chaBotsMX/Robotnik-2024/modelos/Soccer Field 2021 draft v2.png

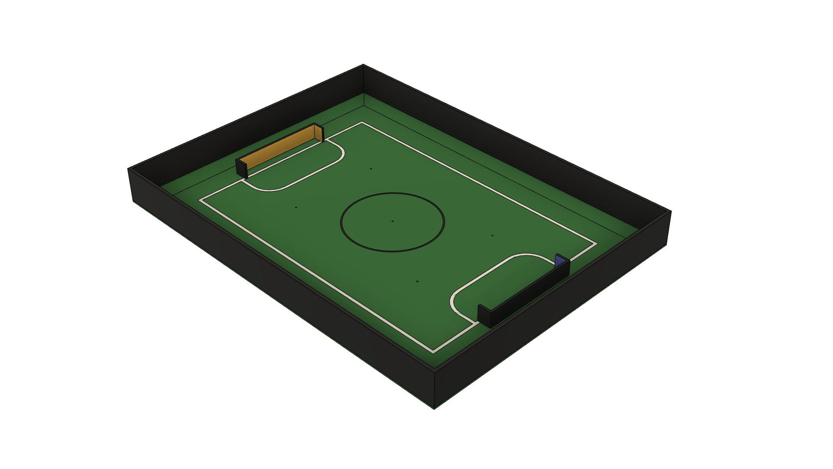
modelos/Soccer Field 2021 draft v2.png
