chaBotsMX/Robotnik-2024/modelos/Soccer Field 2021 draft v2.step

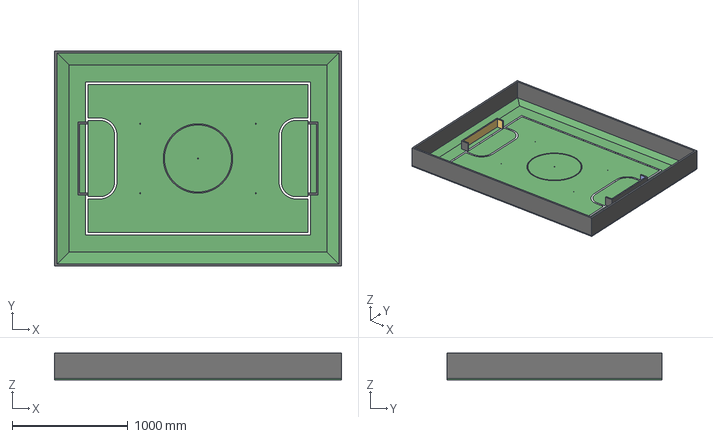
[picture p2: CAD file, 2024-01-22]
modelos/Soccer Field 2021 draft v2.step
2480.0 x 1860.0 x 230.0 mm
