chaBotsMX/Robotnik-2024/pcbs/02_Cople v9.stl

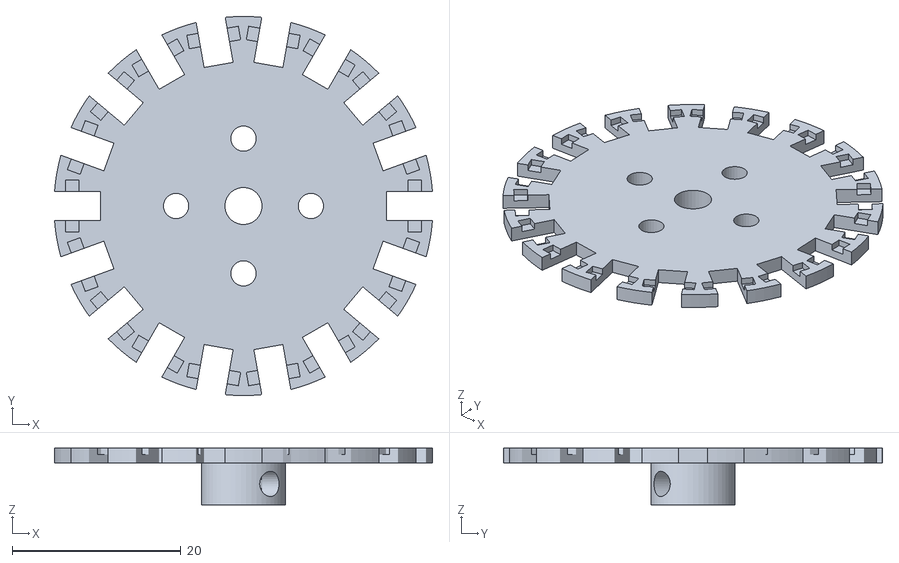
[picture p3: CAD file, 2024-01-18]
pcbs/02_Cople v9.stl
44.9 x 45.0 x 6.75
