chaBotsMX/Robotnik-2024/pcbs/06_Tapita v10.stl

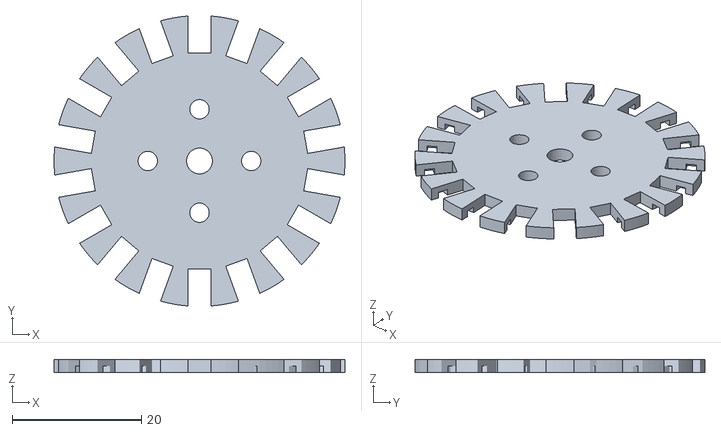
[picture p4: CAD file, 2024-01-18]
pcbs/06_Tapita v10.stl
45.0 x 44.9 x 2.00
