chaBotsMX/Robotnik-2024/pcbs/22_Mirror v8.stl

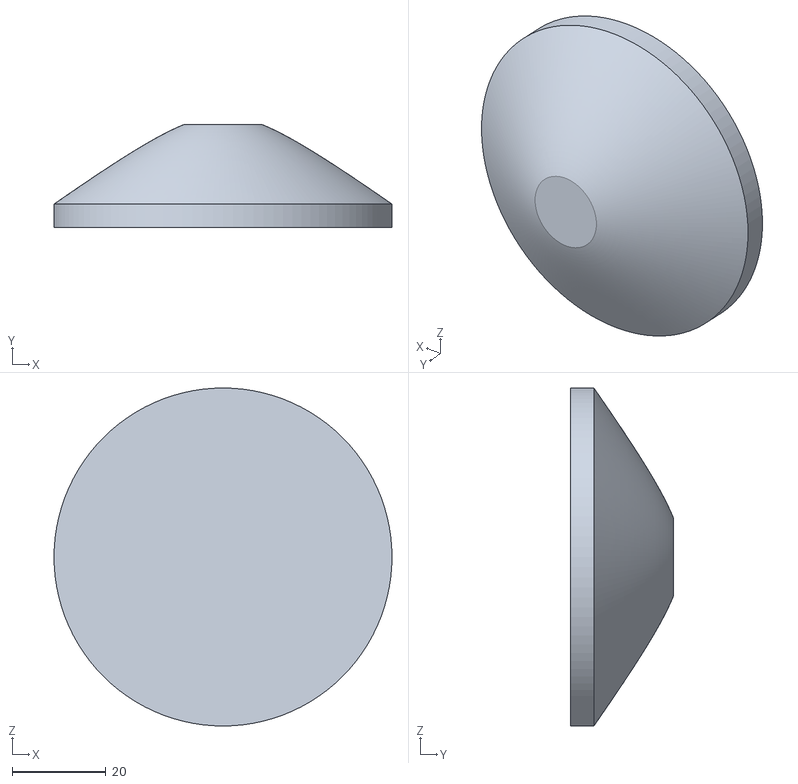
[picture p5: CAD file, 2024-01-18]
pcbs/22_Mirror v8.stl
72.0 x 22.0 x 72.0
