chaBotsMX/Robotnik-2024/pcbs/24_adapter v4.step

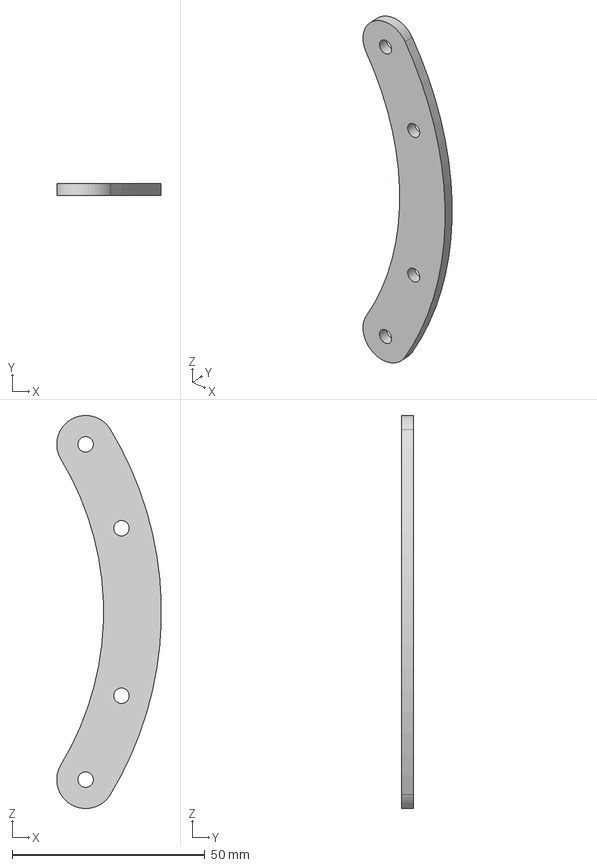
[picture p6: CAD file, 2024-01-18]
pcbs/24_adapter v4.step
27.1 x 3.00 x 101.9 mm
