chaBotsMX/Robotnik-2024/pcbs/11_base_inferior v34.stl

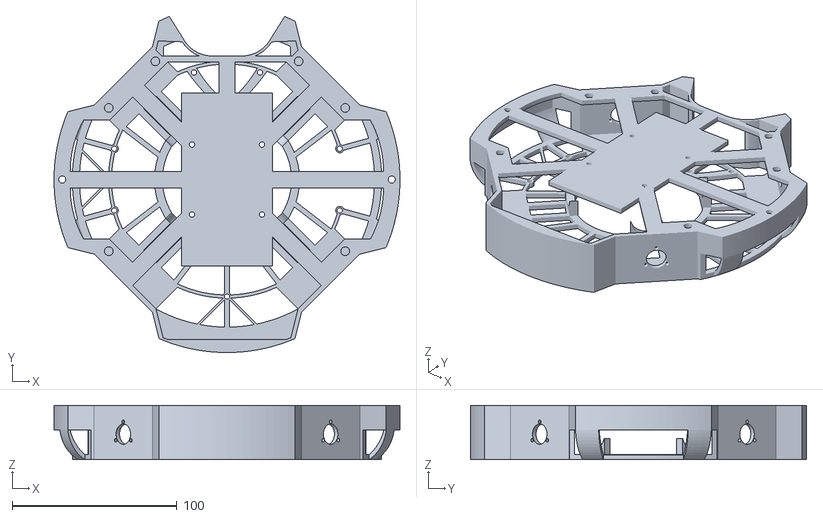
[picture p7: CAD file, 2024-01-18]
pcbs/11_base_inferior v34.stl
210.0 x 204.0 x 33.0
