chaBotsMX/Robotnik-2024/eagle/Layer1.brd

## EAGLE design eagle/Layer1.brd (2024-01-22)

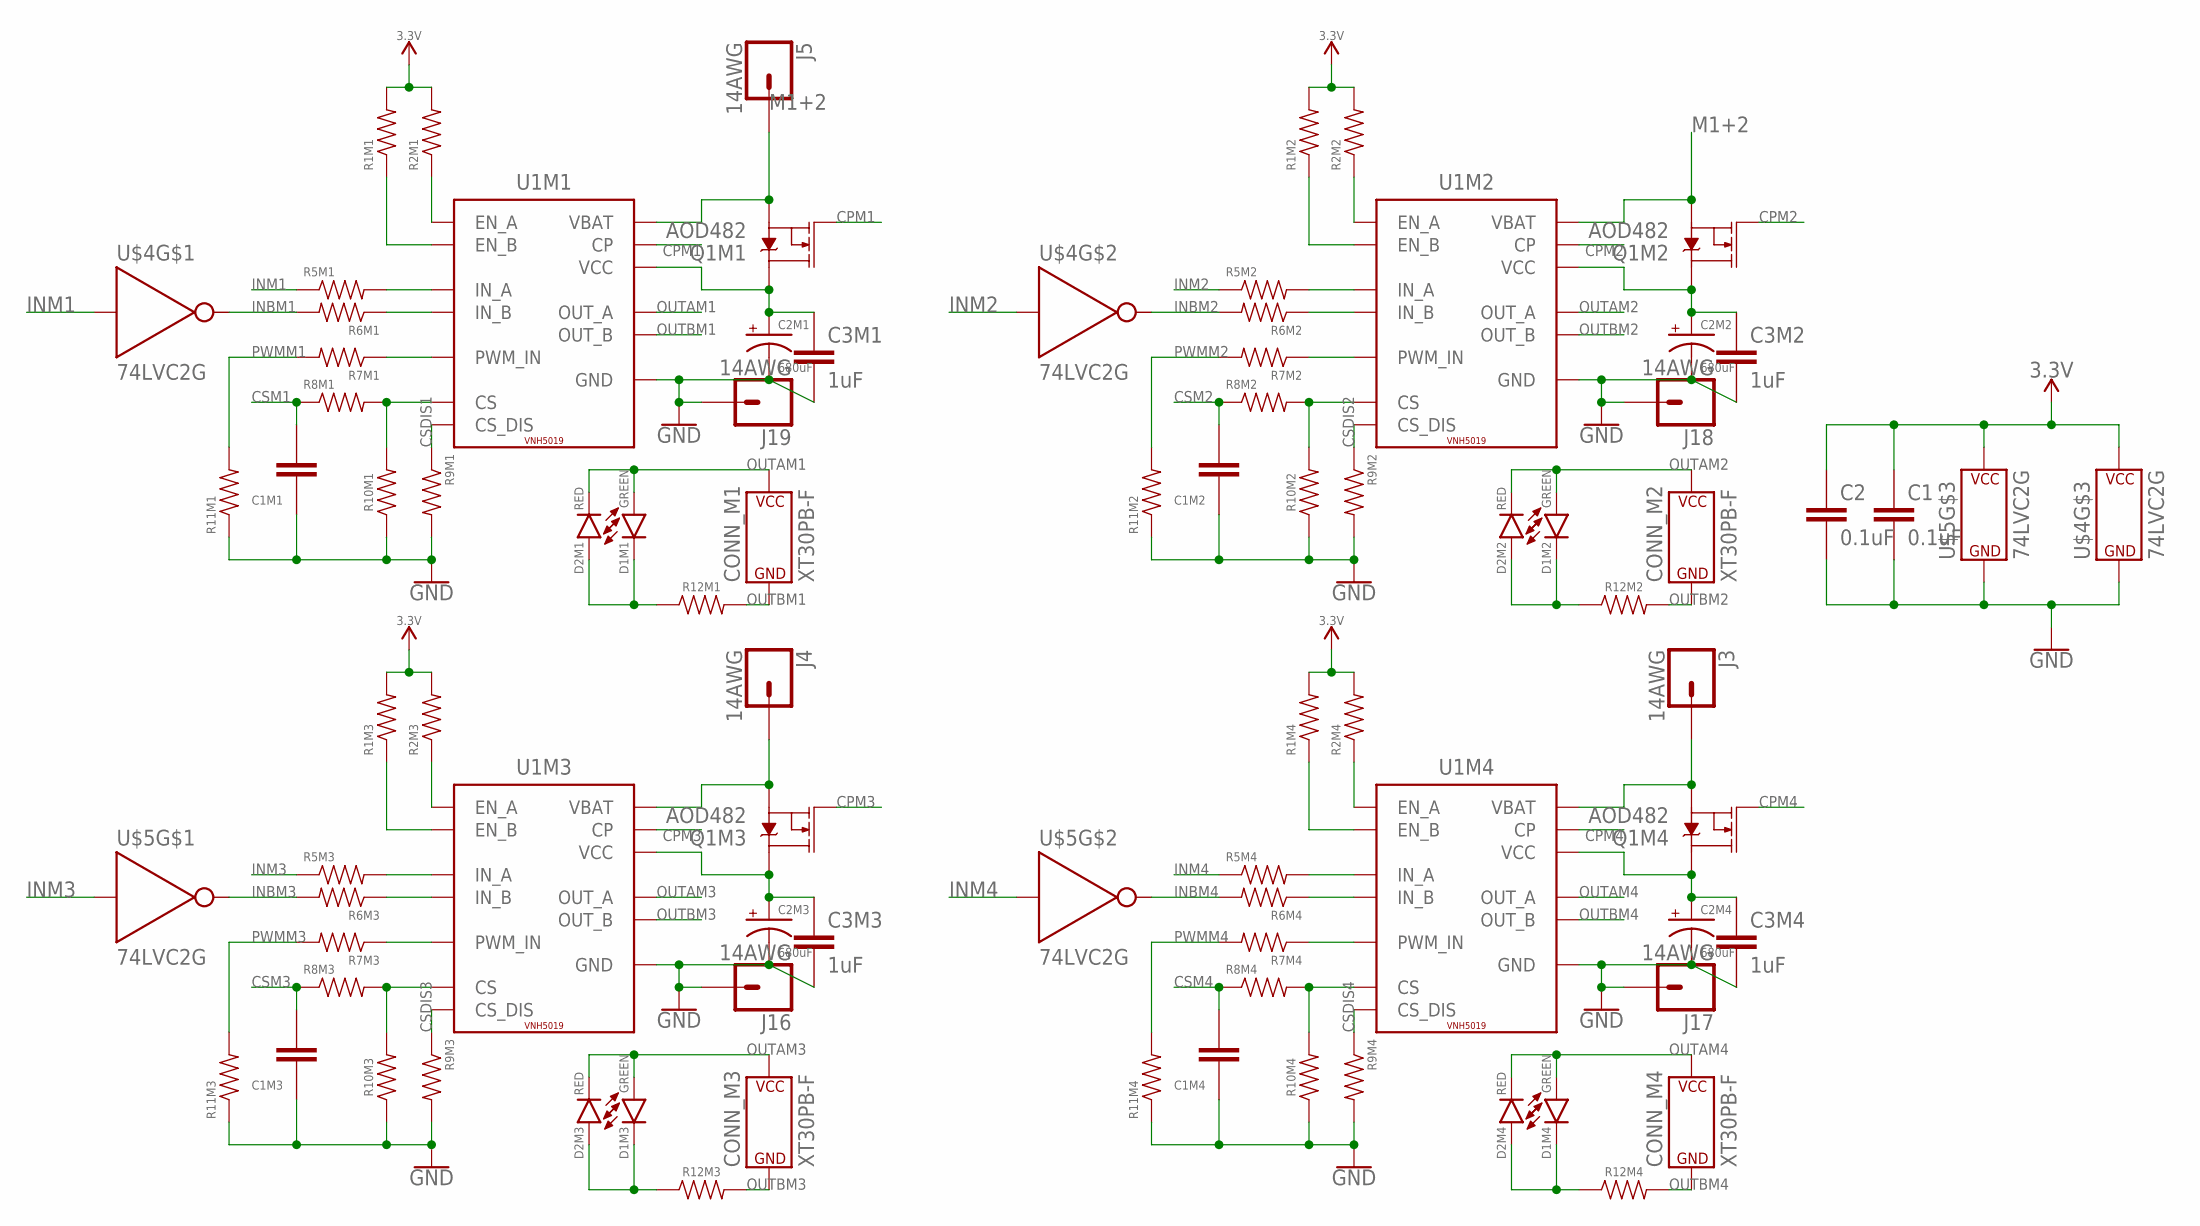
[picture p8: schematic Layer1.sch, sheet 1]

Parts:
C1, C2: 0.1uF; C0603
C1M1, C1M2, C1M3, C1M4: 33nF; C0603
C2M1, C2M2, C2M3, C2M4: 680uF; E3,5-8
C3M1, C3M2, C3M3, C3M4: 1uF; C0603
CONN_M1, CONN_M2, CONN_M3, CONN_M4: XT30PB-F
D1M1, D1M2, D1M3, D1M4: GREEN; LED-0603
D2M1, D2M2, D2M3, D2M4: RED; LED-0603
J3, J4, J5, J16, J17, J18, J19: 14AWG
Q1M1, Q1M2, Q1M3, Q1M4: AOD482; DPAK
R1M1, R1M2, R1M3, R1M4, R2M1, R2M2, R2M3, R2M4: 3.24k; R0603
R5M1, R5M2, R5M3, R5M4, R6M1, R6M2, R6M3, R6M4, R7M1, R7M2, R7M3, R7M4, R10M1, R10M2, R10M3, R10M4: 1k; R0603
R8M1, R8M2, R8M3, R8M4, R9M1, R9M2, R9M3, R9M4, R11M1, R11M2, R11M3, R11M4: 10k; R0603
R12M1, R12M2, R12M3, R12M4: 4.7k; R0603
U1M1, U1M2, U1M3, U1M4: VNH5019; POWERSO-30
U$4, U$5: 74LVC2G; SOT23-6

Connections:
3.3V: C1.1, C2.1, R1M1.2, R1M2.2, R1M3.2, R1M4.2, R2M1.2, R2M2.2, R2M3.2, R2M4.2, U$4.5 (P$V+), U$5.5 (P$V+); also elsewhere on the board
CPM1: Q1M1.1 (G), U1M1.P11 (CP)
CPM2: Q1M2.1 (G), U1M2.P11 (CP)
CPM3: Q1M3.1 (G), U1M3.P11 (CP)
CPM4: Q1M4.1 (G), U1M4.P11 (CP)
CSDIS1: R9M1.1, U1M1.P6 (CS_DIS)
CSDIS2: R9M2.1, U1M2.P6 (CS_DIS)
CSDIS3: R9M3.1, U1M3.P6 (CS_DIS)
CSDIS4: R9M4.1, U1M4.P6 (CS_DIS)
CSM1: C1M1.2, R8M1.1; also elsewhere on the board
CSM2: C1M2.2, R8M2.1; also elsewhere on the board
CSM3: C1M3.2, R8M3.1; also elsewhere on the board
CSM4: C1M4.2, R8M4.1; also elsewhere on the board
GND: C1.2, C1M1.1, C1M2.1, C1M3.1, C1M4.1, C2.2, C2M1.-, C2M2.-, C2M3.-, C2M4.-, C3M1.2, C3M2.2, C3M3.2, C3M4.2, J16.P$1, J17.P$1, J18.P$1, J19.P$1, R9M1.2, R9M2.2, R9M3.2, R9M4.2, R10M1.1, R10M2.1, R10M3.1, R10M4.1, R11M1.1, R11M2.1, R11M3.1, R11M4.1, U1M1.P18 (GND), U1M1.P19 (GND), U1M1.P20 (GND), U1M1.P26 (GND), U1M1.P27 (GND), U1M1.P28 (GND), U1M2.P18 (GND), U1M2.P19 (GND), U1M2.P20 (GND), U1M2.P26 (GND), U1M2.P27 (GND), U1M2.P28 (GND), U1M3.P18 (GND), U1M3.P19 (GND), U1M3.P20 (GND), U1M3.P26 (GND), U1M3.P27 (GND), U1M3.P28 (GND), U1M4.P18 (GND), U1M4.P19 (GND), U1M4.P20 (GND), U1M4.P26 (GND), U1M4.P27 (GND), U1M4.P28 (GND), U$4.2 (P$V-), U$5.2 (P$V-); also elsewhere on the board
INBM1: R6M1.2, U$4.6 (Y)
INBM2: R6M2.2, U$4.4 (Y)
INBM3: R6M3.2, U$5.6 (Y)
INBM4: R6M4.2, U$5.4 (Y)
INM1: R5M1.1, U$4.1 (A); also elsewhere on the board
INM2: R5M2.1, U$4.3 (A); also elsewhere on the board
INM3: R5M3.1, U$5.1 (A); also elsewhere on the board
INM4: R5M4.1, U$5.3 (A); also elsewhere on the board
M1+2: J5.P$1, Q1M1.3 (S), Q1M2.3 (S), U1M1.P12 (VBAT), U1M2.P12 (VBAT)
unnamed: J3.P$1, Q1M4.3 (S), U1M4.P12 (VBAT)
unnamed: J4.P$1, Q1M3.3 (S), U1M3.P12 (VBAT)
unnamed: C2M1.+, C3M1.1, Q1M1.4 (D), U1M1.P3 (VCC), U1M1.P13 (VCC), U1M1.P23 (VCC), U1M1.SLUG1 (VCC)
unnamed: R2M1.1, U1M1.P5 (EN_A)
unnamed: R5M1.2, U1M1.P4 (IN_A)
unnamed: R1M1.1, U1M1.P9 (EN_B)
unnamed: R6M1.1, U1M1.P10 (IN_B)
unnamed: R8M1.2, R10M1.2, U1M1.P8 (CS)
unnamed: R7M1.1, U1M1.P7 (PWM_IN)
unnamed: D1M2.C, D2M2.A, R12M2.1
unnamed: C2M2.+, C3M2.1, Q1M2.4 (D), U1M2.P3 (VCC), U1M2.P13 (VCC), U1M2.P23 (VCC), U1M2.SLUG1 (VCC)
unnamed: R2M2.1, U1M2.P5 (EN_A)
unnamed: R5M2.2, U1M2.P4 (IN_A)
unnamed: R1M2.1, U1M2.P9 (EN_B)
unnamed: R6M2.1, U1M2.P10 (IN_B)
unnamed: R8M2.2, R10M2.2, U1M2.P8 (CS)
unnamed: R7M2.1, U1M2.P7 (PWM_IN)
unnamed: D1M3.C, D2M3.A, R12M3.1
unnamed: C2M3.+, C3M3.1, Q1M3.4 (D), U1M3.P3 (VCC), U1M3.P13 (VCC), U1M3.P23 (VCC), U1M3.SLUG1 (VCC)
unnamed: R2M3.1, U1M3.P5 (EN_A)
unnamed: R5M3.2, U1M3.P4 (IN_A)
unnamed: R1M3.1, U1M3.P9 (EN_B)
unnamed: R6M3.1, U1M3.P10 (IN_B)
unnamed: R8M3.2, R10M3.2, U1M3.P8 (CS)
unnamed: R7M3.1, U1M3.P7 (PWM_IN)
unnamed: D1M4.C, D2M4.A, R12M4.1
unnamed: C2M4.+, C3M4.1, Q1M4.4 (D), U1M4.P3 (VCC), U1M4.P13 (VCC), U1M4.P23 (VCC), U1M4.SLUG1 (VCC)
unnamed: R2M4.1, U1M4.P5 (EN_A)
unnamed: R5M4.2, U1M4.P4 (IN_A)
unnamed: R1M4.1, U1M4.P9 (EN_B)
unnamed: R6M4.1, U1M4.P10 (IN_B)
unnamed: R8M4.2, R10M4.2, U1M4.P8 (CS)
unnamed: R7M4.1, U1M4.P7 (PWM_IN)
unnamed: D1M1.C, D2M1.A, R12M1.1
OUTAM1: CONN_M1.+ (P$V+), D1M1.A, D2M1.C, U1M1.P1 (OUT_A), U1M1.P25 (OUT_A), U1M1.P30 (OUT_A), U1M1.SLUG2 (OUT_A)
OUTAM2: CONN_M2.+ (P$V+), D1M2.A, D2M2.C, U1M2.P1 (OUT_A), U1M2.P25 (OUT_A), U1M2.P30 (OUT_A), U1M2.SLUG2 (OUT_A)
OUTAM3: CONN_M3.+ (P$V+), D1M3.A, D2M3.C, U1M3.P1 (OUT_A), U1M3.P25 (OUT_A), U1M3.P30 (OUT_A), U1M3.SLUG2 (OUT_A)
OUTAM4: CONN_M4.+ (P$V+), D1M4.A, D2M4.C, U1M4.P1 (OUT_A), U1M4.P25 (OUT_A), U1M4.P30 (OUT_A), U1M4.SLUG2 (OUT_A)
OUTBM1: CONN_M1.- (P$V-), R12M1.2, U1M1.P15 (OUT_B), U1M1.P16 (OUT_B), U1M1.P21 (OUT_B), U1M1.SLUG3 (OUT_B)
OUTBM2: CONN_M2.- (P$V-), R12M2.2, U1M2.P15 (OUT_B), U1M2.P16 (OUT_B), U1M2.P21 (OUT_B), U1M2.SLUG3 (OUT_B)
OUTBM3: CONN_M3.- (P$V-), R12M3.2, U1M3.P15 (OUT_B), U1M3.P16 (OUT_B), U1M3.P21 (OUT_B), U1M3.SLUG3 (OUT_B)
OUTBM4: CONN_M4.- (P$V-), R12M4.2, U1M4.P15 (OUT_B), U1M4.P16 (OUT_B), U1M4.P21 (OUT_B), U1M4.SLUG3 (OUT_B)
PWMM1: R7M1.2, R11M1.2; also elsewhere on the board
PWMM2: R7M2.2, R11M2.2; also elsewhere on the board
PWMM3: R7M3.2, R11M3.2; also elsewhere on the board
PWMM4: R7M4.2, R11M4.2; also elsewhere on the board

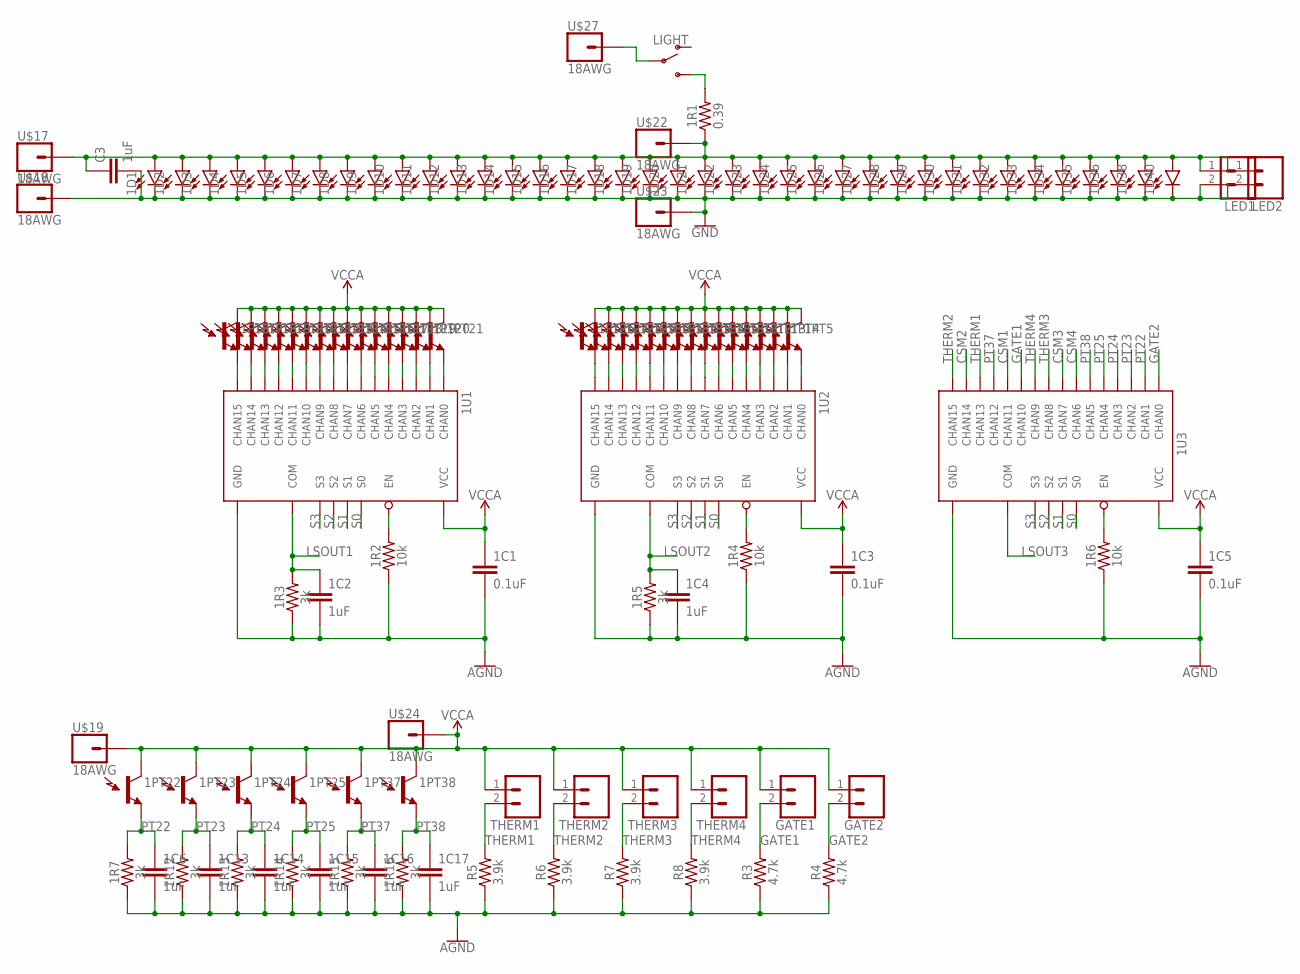
[picture p9: schematic Layer1.sch, sheet 2]

Parts:
1C1, 1C3, 1C5: 0.1uF; C0603
1C2, 1C4, 1C6, 1C13, 1C14, 1C15, 1C16, 1C17: 1uF; C0603
1D1, 1D2, 1D3, 1D4, 1D5, 1D6, 1D7, 1D8, 1D9, 1D10, 1D11, 1D12, 1D13, 1D14, 1D15, 1D16, 1D17, 1D18, 1D19, 1D20, 1D21, 1D22, 1D23, 1D24, 1D25, 1D26, 1D27, 1D28, 1D29, 1D30, 1D31, 1D32, 1D33, 1D34, 1D35, 1D36, 1D38, 1D40: 3528LED; 3528
1PT1, 1PT2, 1PT3, 1PT4, 1PT5, 1PT6, 1PT7, 1PT8, 1PT9, 1PT10, 1PT11, 1PT12, 1PT13, 1PT14, 1PT15, 1PT16, 1PT17, 1PT18, 1PT19, 1PT20, 1PT21, 1PT22, 1PT23, 1PT24, 1PT25, 1PT26, 1PT27, 1PT28, 1PT29, 1PT30, 1PT31, 1PT32, 1PT33, 1PT34, 1PT35, 1PT36, 1PT37, 1PT38: LIGHT_SENSORALS; ALS-PT19
1R1: 0.39; R0603
1R2, 1R4, 1R6: 10k; R0603
1R3, 1R5, 1R7, 1R12, 1R13, 1R14, 1R15, 1R16: 3k; R0603
1U1, 1U2, 1U3: CD74HC4067SSOP-24; SSOP24
C3: 1uF; C0603
GATE1, GATE2: CONN_021X02_NO_SILK; 1X02_NO_SILK
LED1, LED2: CONN_021X02_NO_SILK; 1X02_NO_SILK
LIGHT: SWITCH-SPDT-PTH-11.6X4.0MM-LOCK; SWITCH_SPDT_PTH_11.6X4.0MM_LOCK
R3, R4: 4.7k; R0603
R5, R6, R7, R8: 3.9k; R0603
THERM1, THERM2, THERM3, THERM4: CONN_021X02_NO_SILK; 1X02_NO_SILK
U$17, U$18, U$19, U$22, U$23, U$24, U$27: 18AWG

Connections:
AGND: 1C1.2, 1C2.2, 1C3.2, 1C4.2, 1C5.2, 1C6.2, 1C13.2, 1C14.2, 1C15.2, 1C16.2, 1C17.2, 1R2.1, 1R3.1, 1R4.1, 1R5.1, 1R6.1, 1R7.1, 1R12.1, 1R13.1, 1R14.1, 1R15.1, 1R16.1, 1U1.12 (GND), 1U2.12 (GND), 1U3.12 (GND), R3.1, R4.1, R5.1, R6.1, R7.1, R8.1; also elsewhere on the board
CSM1: 1U3.20 (CHAN11); also elsewhere on the board
CSM2: 1U3.17 (CHAN14); also elsewhere on the board
CSM3: 1U3.2 (CHAN7); also elsewhere on the board
CSM4: 1U3.3 (CHAN6); also elsewhere on the board
GATE1: 1U3.21 (CHAN10), GATE1.2, R3.2
GATE2: 1U3.9 (CHAN0), GATE2.2, R4.2
GND: 1D1.C, 1D2.C, 1D3.C, 1D4.C, 1D5.C, 1D6.C, 1D7.C, 1D8.C, 1D9.C, 1D10.C, 1D11.C, 1D12.C, 1D13.C, 1D14.C, 1D15.C, 1D16.C, 1D17.C, 1D18.C, 1D19.C, 1D20.C, 1D21.C, 1D22.C, 1D23.C, 1D24.C, 1D25.C, 1D26.C, 1D27.C, 1D28.C, 1D29.C, 1D30.C, 1D31.C, 1D32.C, 1D33.C, 1D34.C, 1D35.C, 1D36.C, 1D38.C, 1D40.C, C3.2, LED1.2, LED2.2, U$18.P$1, U$23.P$1; also elsewhere on the board
LSOUT1: 1C2.1, 1R3.2, 1U1.1 (COM); also elsewhere on the board
LSOUT2: 1C4.1, 1R5.2, 1U2.1 (COM); also elsewhere on the board
LSOUT3: 1U3.1 (COM); also elsewhere on the board
unnamed: 1D1.A, 1D2.A, 1D3.A, 1D4.A, 1D5.A, 1D6.A, 1D7.A, 1D8.A, 1D9.A, 1D10.A, 1D11.A, 1D12.A, 1D13.A, 1D14.A, 1D15.A, 1D16.A, 1D17.A, 1D18.A, 1D19.A, 1D20.A, 1D21.A, 1D22.A, 1D23.A, 1D24.A, 1D25.A, 1D26.A, 1D27.A, 1D28.A, 1D29.A, 1D30.A, 1D31.A, 1D32.A, 1D33.A, 1D34.A, 1D35.A, 1D36.A, 1D38.A, 1D40.A, 1R1.1, C3.1, LED1.1, LED2.1, U$17.P$1, U$22.P$1
unnamed: 1PT26.E (E1), 1U2.16 (CHAN15)
unnamed: 1R1.2, LIGHT.3 (S)
unnamed: 1PT27.E (E1), 1U2.17 (CHAN14)
unnamed: 1PT28.E (E1), 1U2.18 (CHAN13)
unnamed: 1PT29.E (E1), 1U2.19 (CHAN12)
unnamed: 1PT30.E (E1), 1U2.20 (CHAN11)
unnamed: 1PT31.E (E1), 1U2.21 (CHAN10)
unnamed: 1PT32.E (E1), 1U2.22 (CHAN9)
unnamed: 1PT33.E (E1), 1U2.23 (CHAN8)
unnamed: 1PT34.E (E1), 1U2.2 (CHAN7)
unnamed: 1PT35.E (E1), 1U2.3 (CHAN6)
unnamed: 1PT36.E (E1), 1U2.4 (CHAN5)
unnamed: 1PT1.E (E1), 1U2.5 (CHAN4)
unnamed: 1PT2.E (E1), 1U2.6 (CHAN3)
unnamed: 1PT3.E (E1), 1U2.7 (CHAN2)
unnamed: 1PT4.E (E1), 1U2.8 (CHAN1)
unnamed: 1PT5.E (E1), 1U2.9 (CHAN0)
unnamed: 1PT6.E (E1), 1U1.16 (CHAN15)
unnamed: 1R2.2, 1U1.15 (EN)
unnamed: 1PT7.E (E1), 1U1.17 (CHAN14)
unnamed: 1PT8.E (E1), 1U1.18 (CHAN13)
unnamed: 1PT9.E (E1), 1U1.19 (CHAN12)
unnamed: 1PT10.E (E1), 1U1.20 (CHAN11)
unnamed: 1PT11.E (E1), 1U1.21 (CHAN10)
unnamed: 1PT12.E (E1), 1U1.22 (CHAN9)
unnamed: 1PT13.E (E1), 1U1.23 (CHAN8)
unnamed: 1PT14.E (E1), 1U1.2 (CHAN7)
unnamed: 1PT15.E (E1), 1U1.3 (CHAN6)
unnamed: 1PT16.E (E1), 1U1.4 (CHAN5)
unnamed: 1PT17.E (E1), 1U1.5 (CHAN4)
unnamed: 1PT18.E (E1), 1U1.6 (CHAN3)
unnamed: 1PT19.E (E1), 1U1.7 (CHAN2)
unnamed: 1PT20.E (E1), 1U1.8 (CHAN1)
unnamed: 1PT21.E (E1), 1U1.9 (CHAN0)
unnamed: LIGHT.2, U$27.P$1
unnamed: 1R4.2, 1U2.15 (EN)
unnamed: 1R6.2, 1U3.15 (EN)
PT22: 1C6.1, 1PT22.E (E1), 1R7.2, 1U3.8 (CHAN1)
PT23: 1C13.1, 1PT23.E (E1), 1R12.2, 1U3.7 (CHAN2)
PT24: 1C14.1, 1PT24.E (E1), 1R13.2, 1U3.6 (CHAN3)
PT25: 1C15.1, 1PT25.E (E1), 1R14.2, 1U3.5 (CHAN4)
PT37: 1C16.1, 1PT37.E (E1), 1R15.2, 1U3.19 (CHAN12)
PT38: 1C17.1, 1PT38.E (E1), 1R16.2, 1U3.4 (CHAN5)
S0: 1U1.10 (S0), 1U2.10 (S0), 1U3.10 (S0); also elsewhere on the board
S1: 1U1.11 (S1), 1U2.11 (S1), 1U3.11 (S1); also elsewhere on the board
S2: 1U1.14 (S2), 1U2.14 (S2), 1U3.14 (S2); also elsewhere on the board
S3: 1U1.13 (S3), 1U2.13 (S3), 1U3.13 (S3); also elsewhere on the board
THERM1: 1U3.18 (CHAN13), R5.2, THERM1.2
THERM2: 1U3.16 (CHAN15), R6.2, THERM2.2
THERM3: 1U3.23 (CHAN8), R7.2, THERM3.2
THERM4: 1U3.22 (CHAN9), R8.2, THERM4.2
VCCA: 1C1.1, 1C3.1, 1C5.1, 1PT1.C (C1), 1PT2.C (C1), 1PT3.C (C1), 1PT4.C (C1), 1PT5.C (C1), 1PT6.C (C1), 1PT7.C (C1), 1PT8.C (C1), 1PT9.C (C1), 1PT10.C (C1), 1PT11.C (C1), 1PT12.C (C1), 1PT13.C (C1), 1PT14.C (C1), 1PT15.C (C1), 1PT16.C (C1), 1PT17.C (C1), 1PT18.C (C1), 1PT19.C (C1), 1PT20.C (C1), 1PT21.C (C1), 1PT22.C (C1), 1PT23.C (C1), 1PT24.C (C1), 1PT25.C (C1), 1PT26.C (C1), 1PT27.C (C1), 1PT28.C (C1), 1PT29.C (C1), 1PT30.C (C1), 1PT31.C (C1), 1PT32.C (C1), 1PT33.C (C1), 1PT34.C (C1), 1PT35.C (C1), 1PT36.C (C1), 1PT37.C (C1), 1PT38.C (C1), 1U1.24 (VCC), 1U2.24 (VCC), 1U3.24 (VCC), GATE1.1, GATE2.1, THERM1.1, THERM2.1, THERM3.1, THERM4.1, U$19.P$1, U$24.P$1; also elsewhere on the board

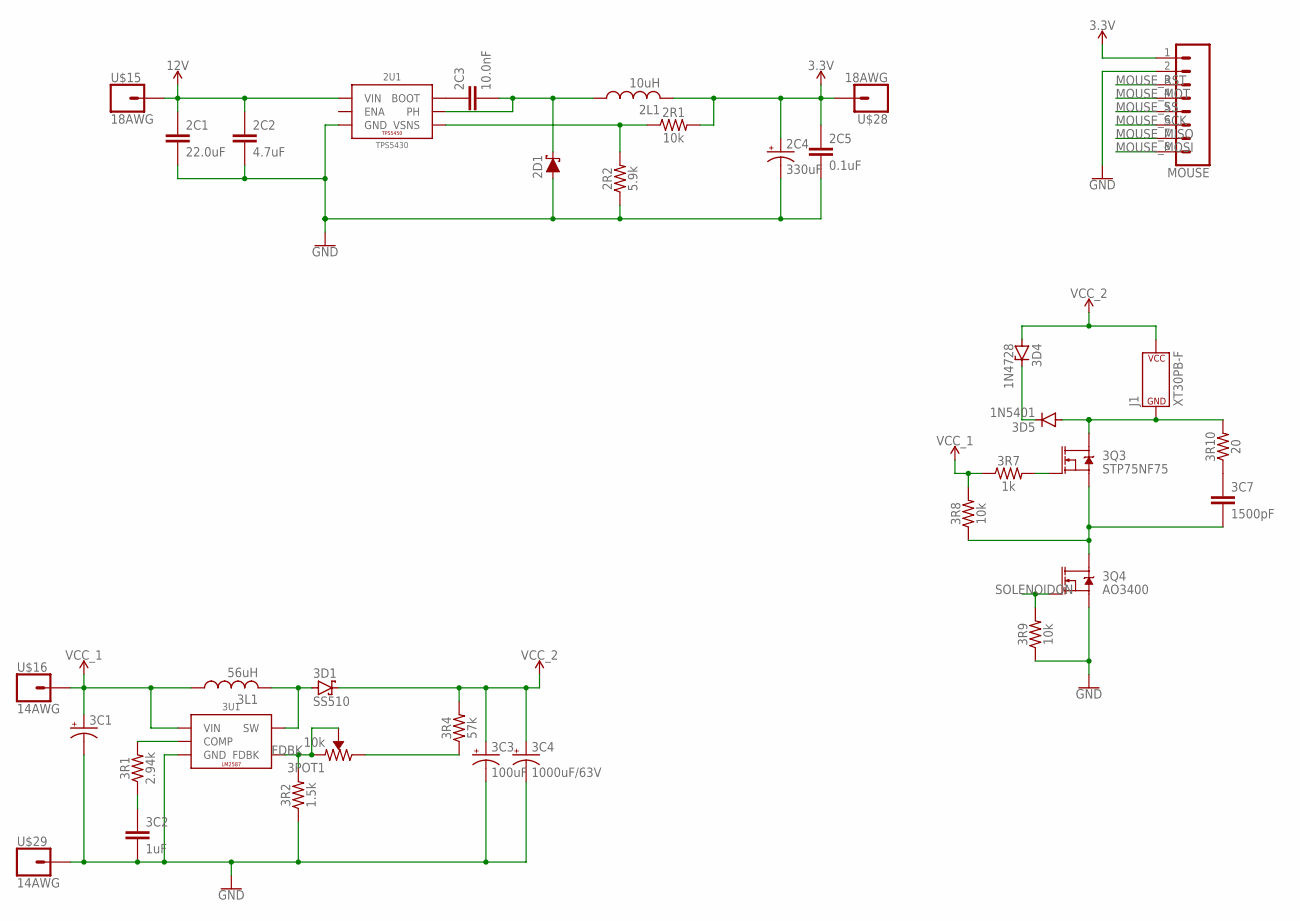
[picture p10: schematic Layer1.sch, sheet 3]

Parts:
2C1: 22.0uF; C1210
2C2: 4.7uF; C0603
2C3: 10.0nF; C0603
2C4: 330uF; D/7343-31R
2C5: 0.1uF; C0603
2D1: SS54; SMA-DIODE
2L1: 10uH; SWPA8040
2R1, 3R8, 3R9: 10k; R0603
2R2: 5.9k; R0603
2U1: TPS5430; POWERPAD-SOIC-8
3C1: 100uF; PANASONIC_D
3C2: 1uF; C0603
3C3: 100uF; NIC_10X10.5_CAP
3C4: 1000uF/63V; 1000UF-CAP
3C7: 1500pF; C0603
3D1: SS510; SMB
3D4: 1N4728; DO41Z10
3D5: 1N5401; DO201-15
3L1: 56uH; CDRH127
3POT1: 10k; 3296-TRIMPOT
3Q3: STP75NF75; TO220V
3Q4: AO3400; SOT23-3
3R1: 2.94k; R0603
3R2: 1.5k; R0603
3R4: 57k; R0603
3R7: 1k; R0603
3R10: 20; R0603
3U1: LM2587; TO-263
J1: XT30PB-F
MOUSE: CONN_08LOCK; 1X08_LOCK
U$15, U$28: 18AWG
U$16, U$29: 14AWG

Connections:
3.3V: 2C4.+, 2C5.1, 2L1.P2 (2), 2R1.2, MOUSE.1, U$28.P$1; also elsewhere on the board
12V: 2C1.1, 2C2.1, 2U1.7 (VIN), U$15.P$1
FDBK: 3POT1.1 (CCW), 3POT1.2 (WIPER), 3R2.2, 3U1.P2 (FDBK)
GND: 2C1.2, 2C2.2, 2C4.-, 2C5.2, 2D1.A, 2R2.1, 2U1.6 (GND), 2U1.9 (GND), 2U1.P$1 (GND), 2U1.P$2 (GND), 2U1.P$3 (GND), 2U1.P$4 (GND), 2U1.P$5 (GND), 2U1.P$6 (GND), 3C1.-, 3C2.2, 3C3.-, 3C4.-, 3Q4.2 (S), 3R2.1, 3R9.1, 3U1.P3 (GND), 3U1.P$1 (GND), 3U1.P$2 (GND), 3U1.P$3 (GND), 3U1.P$4 (GND), 3U1.P$5 (GND), 3U1.P$6 (GND), 3U1.P$7 (GND), 3U1.P$8 (GND), 3U1.P$9 (GND), 3U1.P$10 (GND), 3U1.P$11 (GND), 3U1.P$12 (GND), 3U1.P$13 (GND), 3U1.P$14 (GND), 3U1.P$15 (GND), 3U1.P$16 (GND), 3U1.P$17 (GND), 3U1.P$18 (GND), 3U1.P$19 (GND), 3U1.P$20 (GND), 3U1.TAB (GND), MOUSE.2, U$29.P$1; also elsewhere on the board
MOUSE_MISO: MOUSE.7; also elsewhere on the board
MOUSE_MOSI: MOUSE.8; also elsewhere on the board
MOUSE_MOT: MOUSE.4; also elsewhere on the board
MOUSE_RST: MOUSE.3; also elsewhere on the board
MOUSE_SCK: MOUSE.6; also elsewhere on the board
MOUSE_SS: MOUSE.5; also elsewhere on the board
unnamed: 3POT1.3 (CW), 3R4.1
unnamed: 3D1.A, 3L1.2, 3U1.P4 (SW)
unnamed: 3R1.2, 3U1.P1 (COMP)
unnamed: 3C2.1, 3R1.1
unnamed: 3C7.2, 3Q3.3 (S), 3Q4.3 (D), 3R8.1
unnamed: 3Q3.1 (G), 3R7.2
unnamed: 3D4.C, 3D5.C
unnamed: 2C3.2, 2D1.C, 2L1.P1 (1), 2U1.8 (PH)
unnamed: 2R1.1, 2R2.2, 2U1.4 (VSNS)
unnamed: 2C3.1, 2U1.1 (BOOT)
unnamed: 3C7.1, 3R10.1
SOLENOIDGND: 3D5.A, 3Q3.2 (D), 3R10.2, J1.- (P$V-)
SOLENOIDON: 3Q4.1 (G), 3R9.2; also elsewhere on the board
VCC_1: 3C1.+, 3L1.1, 3R7.1, 3R8.2, 3U1.P5 (VIN), U$16.P$1
VCC_2: 3C3.+, 3C4.+, 3D1.C, 3D4.A, 3R4.2, J1.+ (P$V+)

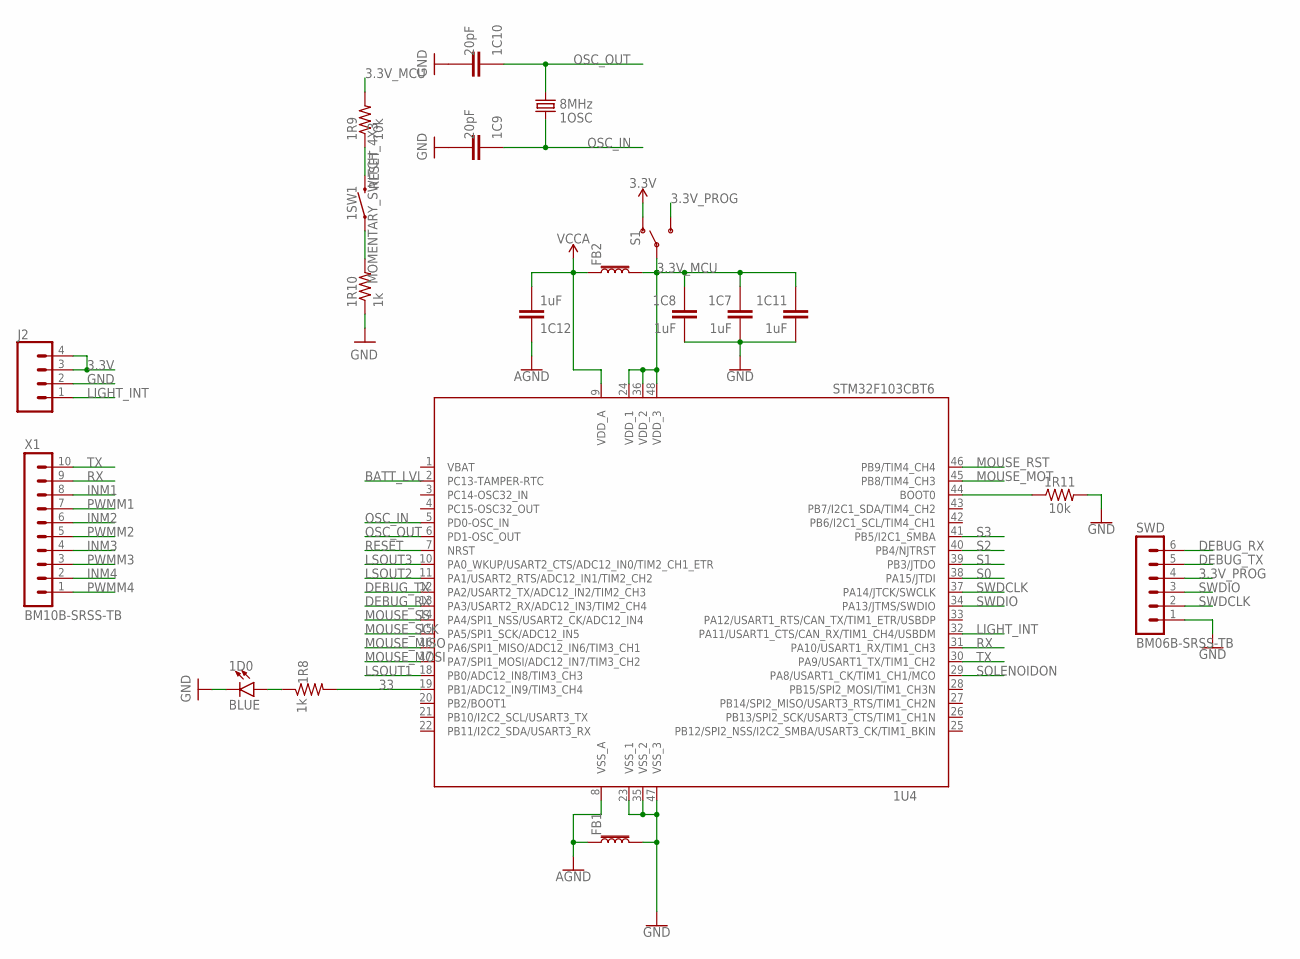
[picture p11: schematic Layer1.sch, sheet 4]

Parts:
1C7, 1C8, 1C11, 1C12: 1uF; C0603
1C9, 1C10: 20pF; C0603
1D0: BLUE; LED-0603
1OSC: 8MHz; CRYSTAL-SMD-5X3.2-2PAD
1R8, 1R10: 1k; R0603
1R9, 1R11: 10k; R0603
1SW1: MOMENTARY_SWITCH_4X3
1U4: STM32F103CBT6; LQFP48
FB1, FB2: 30Ω/1.8A; 0603
J2: CONN_04; 1X04
S1: SWITCH-SPDT-PTH-11.6X4.0MM-LOCK; SWITCH_SPDT_PTH_11.6X4.0MM_LOCK
SWD: BM06B-SRSS-TB
X1: BM10B-SRSS-TB

Connections:
3.3V: J2.3, J2.4, S1.1 (O); also elsewhere on the board
3.3V_MCU: 1C7.1, 1C8.1, 1C11.1, 1R9.2, 1U4.24 (VDD_1), 1U4.36 (VDD_2), 1U4.48 (VDD_3), FB2.2, S1.2
3.3V_PROG: S1.3 (S), SWD.4
33: 1R8.2, 1U4.19 (PB1/ADC12_IN9/TIM3_CH4)
AGND: 1C12.1, 1U4.8 (VSS_A), FB1.1; also elsewhere on the board
BATT_LVL: 1U4.2 (PC13-TAMPER-RTC); also elsewhere on the board
DEBUG_RX: 1U4.13 (PA3/USART2_RX/ADC12_IN3/TIM2_CH4), SWD.6
DEBUG_TX: 1U4.12 (PA2/USART2_TX/ADC12_IN2/TIM2_CH3), SWD.5
GND: 1C7.2, 1C8.2, 1C9.2, 1C10.2, 1C11.2, 1D0.C, 1R10.1, 1R11.2, 1U4.23 (VSS_1), 1U4.35 (VSS_2), 1U4.47 (VSS_3), FB1.2, J2.2, SWD.1; also elsewhere on the board
INM1: X1.8; also elsewhere on the board
INM2: X1.6; also elsewhere on the board
INM3: X1.4; also elsewhere on the board
INM4: X1.2; also elsewhere on the board
LIGHT_INT: 1U4.32 (PA11/USART1_CTS/CAN_RX/TIM1_CH4/USBDM), J2.1
LSOUT1: 1U4.18 (PB0/ADC12_IN8/TIM3_CH3); also elsewhere on the board
LSOUT2: 1U4.11 (PA1/USART2_RTS/ADC12_IN1/TIM2_CH2); also elsewhere on the board
LSOUT3: 1U4.10 (PA0_WKUP/USART2_CTS/ADC12_IN0/TIM2_CH1_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); also elsewhere on the board
MOUSE_MISO: 1U4.16 (PA6/SPI1_MISO/ADC12_IN6/TIM3_CH1); also elsewhere on the board
MOUSE_MOSI: 1U4.17 (PA7/SPI1_MOSI/ADC12_IN7/TIM3_CH2); also elsewhere on the board
MOUSE_MOT: 1U4.45 (PB8/TIM4_CH3); also elsewhere on the board
MOUSE_RST: 1U4.46 (PB9/TIM4_CH4); also elsewhere on the board
MOUSE_SCK: 1U4.15 (PA5/SPI1_SCK/ADC12_IN5); also elsewhere on the board
MOUSE_SS: 1U4.14 (PA4/SPI1_NSS/USART2_CK/ADC12_IN4); also elsewhere on the board
unnamed: 1R10.2, 1SW1.P$1 (1)
unnamed: 1D0.A, 1R8.1
unnamed: 1R11.1, 1U4.44 (BOOT0)
OSC_IN: 1C9.1, 1OSC.P$2 (2), 1U4.5 (PD0-OSC_IN)
OSC_OUT: 1C10.1, 1OSC.P$1 (1), 1U4.6 (PD1-OSC_OUT)
PWMM1: X1.7; also elsewhere on the board
PWMM2: X1.5; also elsewhere on the board
PWMM3: X1.3; also elsewhere on the board
PWMM4: X1.1; also elsewhere on the board
RESET: 1R9.1, 1SW1.P$2 (2), 1U4.7 (NRST)
RX: 1U4.31 (PA10/USART1_RX/TIM1_CH3), X1.9
S0: 1U4.38 (PA15/JTDI); also elsewhere on the board
S1: 1U4.39 (PB3/JTDO); also elsewhere on the board
S2: 1U4.40 (PB4/NJTRST); also elsewhere on the board
S3: 1U4.41 (PB5/I2C1_SMBA); also elsewhere on the board
SOLENOIDON: 1U4.29 (PA8/USART1_CK/TIM1_CH1/MCO); also elsewhere on the board
SWDCLK: 1U4.37 (PA14/JTCK/SWCLK), SWD.2
SWDIO: 1U4.34 (PA13/JTMS/SWDIO), SWD.3
TX: 1U4.30 (PA9/USART1_TX/TIM1_CH2), X1.10
VBAT: 1U4.1 (VBAT)
VCCA: 1C12.2, 1U4.9 (VDD_A), FB2.1; also elsewhere on the board

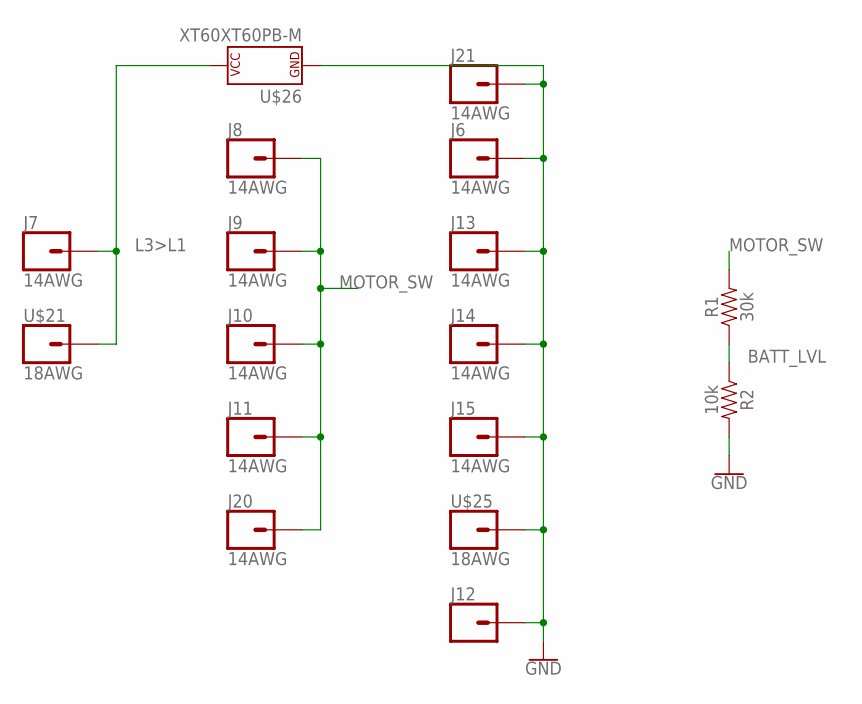
[picture p12: schematic Layer1.sch, sheet 5]

Parts:
J6, J7, J8, J9, J10, J11, J13, J14, J15, J20, J21: 14AWG
J12: CONN_01; 1X01
R1: 30k; R0603
R2: 10k; R0603
U$21, U$25: 18AWG
U$26: XT60XT60PB-M; XT60PB-M

Connections:
BATT_LVL: R1.1, R2.1; also elsewhere on the board
GND: J6.P$1, J12.1, J13.P$1, J14.P$1, J15.P$1, J21.P$1, R2.2, U$25.P$1, U$26.- (P$V-); also elsewhere on the board
L3>L1: J7.P$1, U$21.P$1, U$26.+ (P$V+)
MOTOR_SW: J8.P$1, J9.P$1, J10.P$1, J11.P$1, J20.P$1, R1.2

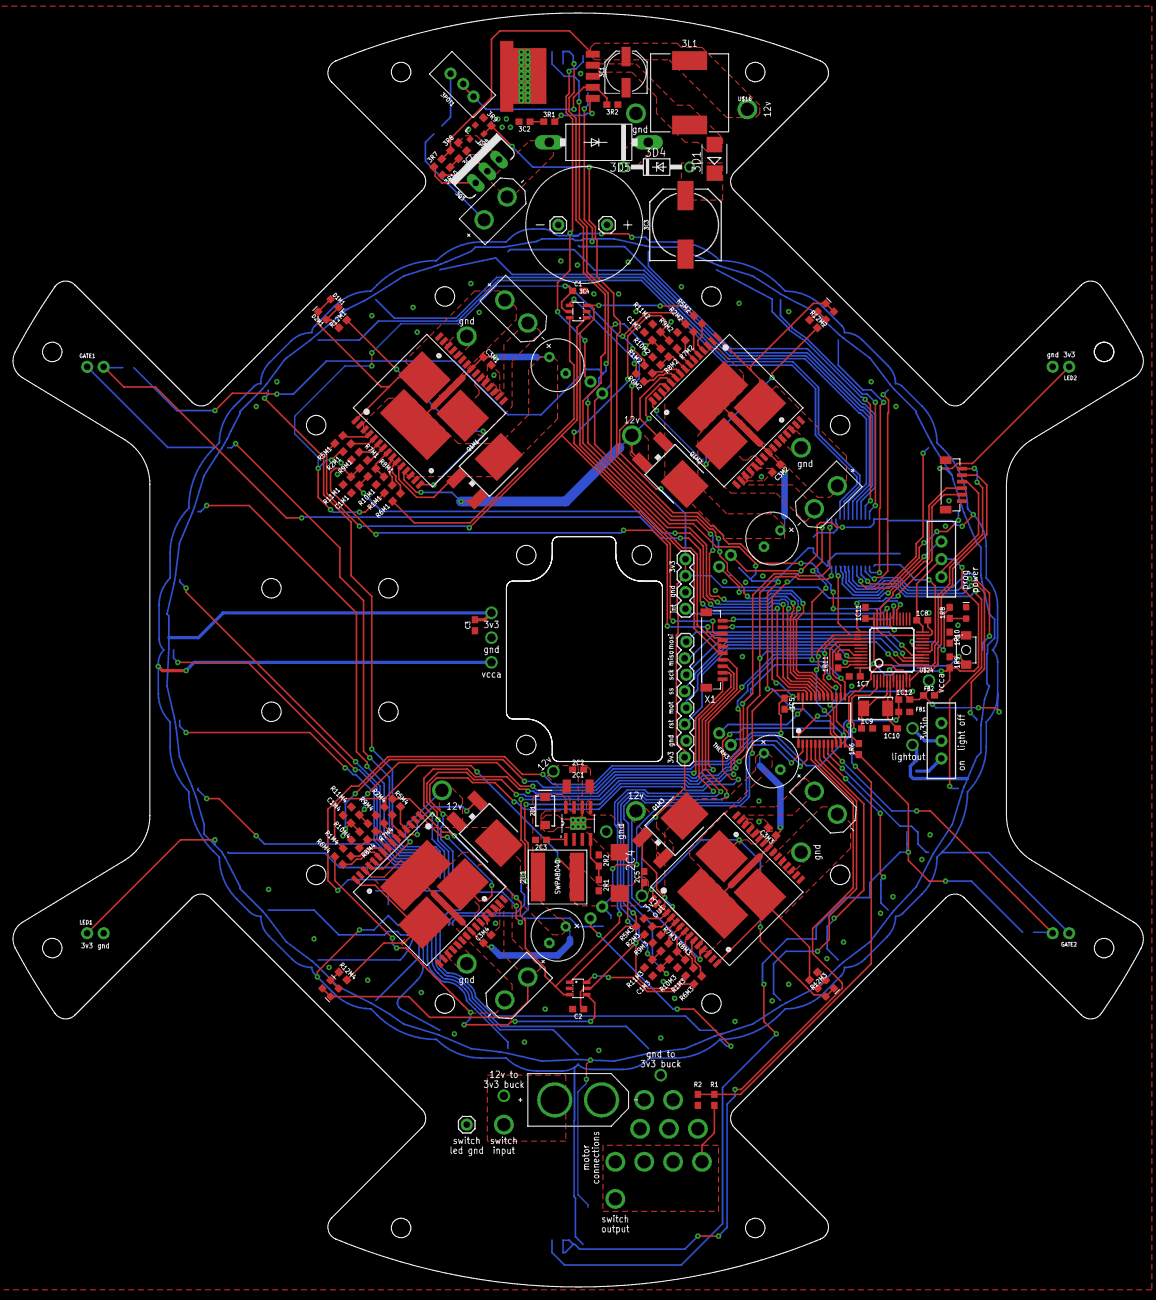
[picture p13: board Layer1.brd from above]

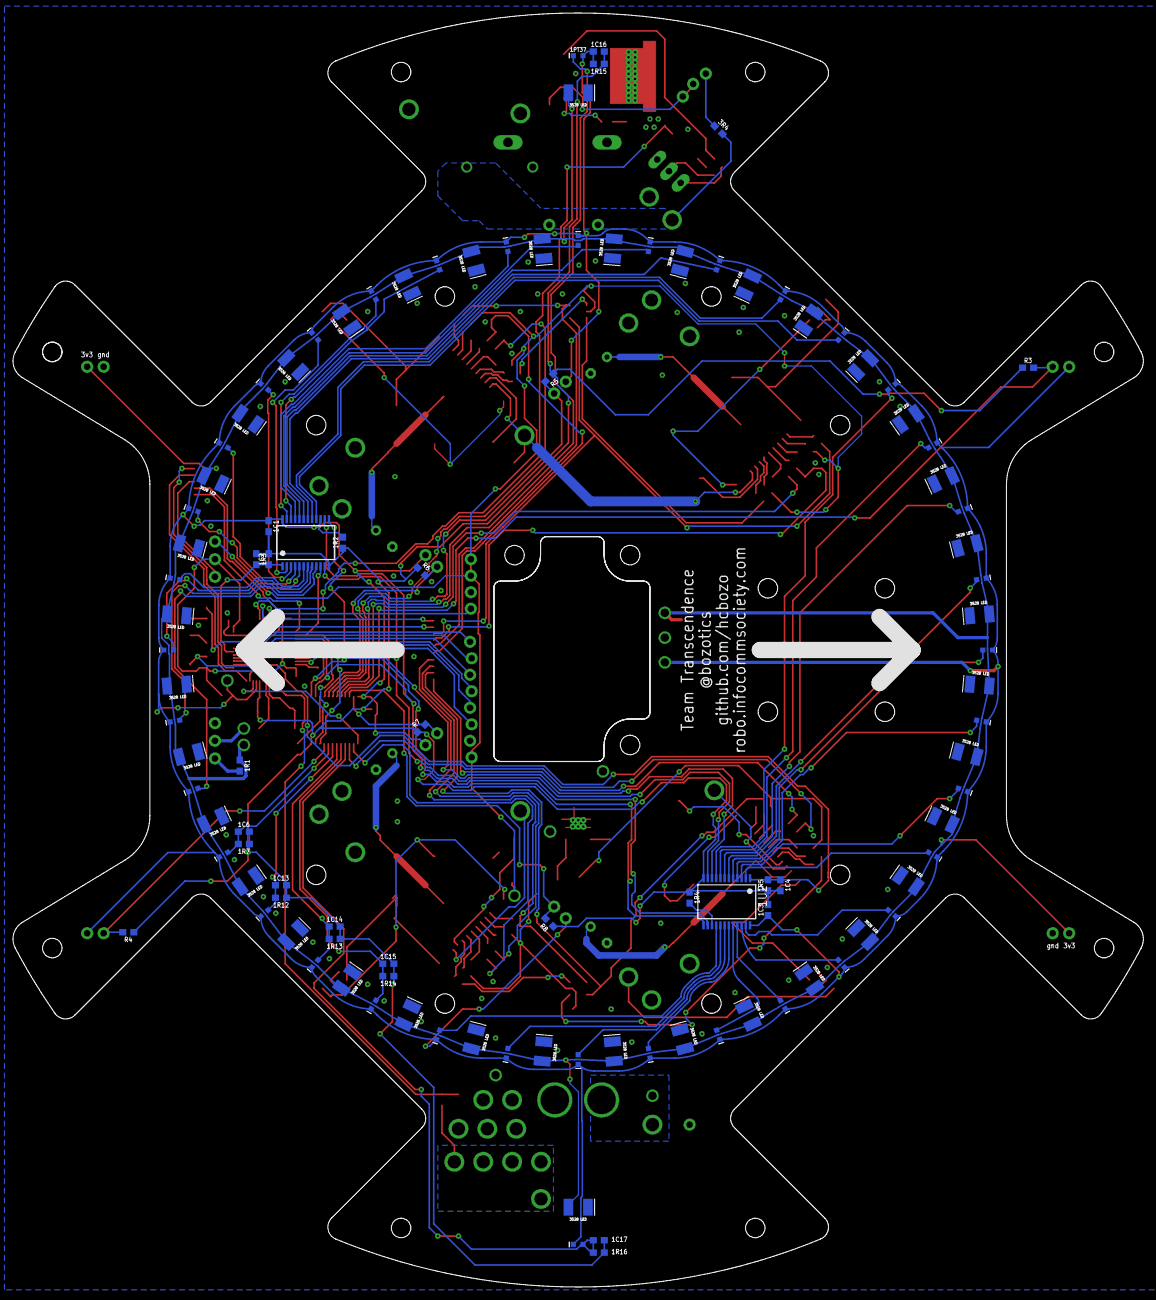
[picture p14: board Layer1.brd from below]

Board: 2 copper layers, 173.9 x 196.0 mm, 281 parts (106 on the bottom side), 170 nets.
