chaBotsMX/Robotnik-2024/produccion/portero_0.1/Main_Pcb_comMejorada_portero/Main_Pcb_comMejorada_portero.ino

#include <Wire.h>
#include <BohleBots_BNO055.h>
int pwm = 150;
int sendPWM;
int stop = 0;
int angEsp = 200;
int data1[2] = {0,0}; //Angulo de la pelota IR partido en 2 bytes

int data5[5] = {0,0,0,0,0}; // byte 1 y 2 son para enviar el anguloIR de la pelota, 3 y 4 el offset del imu y el 5 para enviar el pwm maximo 
int xCord, yCord;
int pelota1 = 0, pelota2 = 0, orientacion1 = 0, orientacion2 = 0, anguloIR = 200; // declaramos los bytes para poder trabajar con ellos 

#define intensidad_constante 140
#define intensidad_cuadrado 19600

int IMU, norte; //varaibles usadas para los calculos del imu

int lastIMU;
int goalAngle=0;

int estado, intensidad = 0;

int calibracionImu;

int ceroFake;
int setX = 100, setY = 63;
int xPorteria,  yPorteria;
int communicationMV = 1;
enum State {
  WAIT_FOR_START,
  READ_ANGLE_HIGH,
  READ_ANGLE_LOW,
  READ_INTENSITY_HIGH,
  READ_INTENSITY_LOW,
  READ_CHECKSUM,
  WAIT_FOR_END
};

const int TAMANO_DATOS = 3;
int datos[TAMANO_DATOS];

String inputString = ""; 
bool stringComplete = false;
bool peligro = false;
// Variables globales para almacenar el ángulo e intensidad
int globalAngle = 400;
int globalIntensity = 0;
int localAngle = 0;
int localIntensity=0;
// Estado inicial
State currentState = WAIT_FOR_START;
int xMax = 145, xMin = 75 ;
// Variable para calcular el checksum
byte calculatedChecksum = 0;

int mover = 1;
BNO bno;  //create bno from the Class BNO

elapsedMillis stopTimer;

elapsedMillis uart2timer;
elapsedMillis irTimer;
void uartStart(){
  Serial.begin(115200); //comunicacion con pc
  delay(1000);
  Serial1.begin(57600); //anillo de ir
  delay(1000);
  Serial2.begin(115200); //M5
  delay(1000);
  Serial3.begin(115200, 0X00);//sensor de linea
  delay(1000);
  Serial4.begin(9600); //openMV
  delay(1000);
  Serial5.begin(115200); // comunicacion con placa de motores
  delay(1000); //tiempo para sincronizar

}

       


void getUartInfo(){

 if (Serial1.available() > 0) {
    byte incomingByte = Serial1.read();

    switch (currentState) {
      case WAIT_FOR_START:
        if (incomingByte == 255) {
          currentState = READ_ANGLE_HIGH;
          calculatedChecksum = 0; // Resetea el checksum al empezar un nuevo mensaje
        }
        break;

      case READ_ANGLE_HIGH:
        localAngle = incomingByte * 255;
       // Serial.println(incomingByte);
        
        calculatedChecksum += incomingByte;
        currentState = READ_ANGLE_LOW;
        break;

      case READ_ANGLE_LOW:
        localAngle = localAngle + incomingByte;
        //Serial.println(incomingByte);
        //Serial.println(localAngle);
        calculatedChecksum += incomingByte;
        currentState = READ_INTENSITY_HIGH;
        break;

      case READ_INTENSITY_HIGH:
        localIntensity=incomingByte*255;

        calculatedChecksum += incomingByte;
        currentState = READ_INTENSITY_LOW;
        break;

      case READ_INTENSITY_LOW:
        localIntensity+=incomingByte;

        calculatedChecksum += incomingByte;
        currentState = READ_CHECKSUM;
        break;

      case READ_CHECKSUM:
        // Verifica el checksum
        if (calculatedChecksum == incomingByte) {
          currentState = WAIT_FOR_END;
        } else {
          // Checksum no coincide, intenta resincronizar
          //Serial.println("Error en el checksum, intentando resincronizar...");
          currentState = WAIT_FOR_START;
        }
        break;

      case WAIT_FOR_END:
        if (incomingByte == 254) {
          // Mensaje completo y correcto, procesa los datos
          //Serial.println("Mensaje recibido correctamente.");
          // Aquí iría la lógica para procesar los datos recibidos
          if(localAngle > 360){
            globalAngle = 400;
          }
          else{
            globalAngle = localAngle;
          }
     
          globalIntensity=localIntensity;
         //Serial.print("angulo global: ");Serial.println(globalAngle);
          irTimer = 0;
        } else {
          // Fin de mensaje incorrecto, intenta resincronizar
         // Serial.println("Fin de mensaje incorrecto, intentando resincronizar...");
        }
        currentState = WAIT_FOR_START; // Vuelve al inicio para recibir un nuevo mensaje
        break;
    }
  }
  else{
    if(irTimer > 5){
    globalAngle= 400;
    Serial.println("no hay ir");
    }
  }


  if (Serial2.available())
  {
    estado = Serial2.read();
    //Serial.println(estado);
  }
  if(Serial3.available())
  {
    angEsp = Serial3.read();
    //Serial.println(angEsp);
  }

  openMVSetup();

}

void openMVSetup(){
static String inputString = "";  // Un String para acumular los caracteres recibidos
  //Serial.println("intentando comunicar");
  while (Serial4.available()) {
    char inChar = (char)Serial4.read();
    inputString += inChar;

    // Si recibes un salto de línea, has recibido un mensaje completo
    if (inChar == '\n') {
      inputString.trim();  // Elimina espacios en blanco y el salto de línea

      // Aquí procesas el mensaje
     // Serial.print("Recibido: ");
      //Serial.println(inputString);

      // Divide el string por la coma para extraer X e Y
      int commaIndex = inputString.indexOf(',');
      if (commaIndex != -1) {
        String xStr = inputString.substring(0, commaIndex);
        String yStr = inputString.substring(commaIndex + 1);

        int x = xStr.toInt();
        int y = yStr.toInt();

        // Haz algo con x e y aquí
        Serial.print("X: ");
        Serial.print(x);
        xPorteria = x;
        Serial.print(", Y: ");
        yPorteria = y;
        Serial.println(y);
      }

      // Limpia el string para el próximo mensaje
      inputString = "";
    }
  }  
} 
void llenarDatos() {
  datos[0] = bno._calibData.acc;
  datos[1] = bno._calibData.gyr;
  datos[2] = bno._calibData.mag;
  enviarDatosUART2();
}

void enviarDatosUART2(){
  // Crea un string para almacenar los datos
  String mensaje = "";

  // Agrega cada entero al string, separado por comas
  for (int i = 0; i < TAMANO_DATOS; i++) {
    mensaje += String(datos[i]);
    if (i < TAMANO_DATOS - 1) {
      mensaje += ",";
    }
  }

  // Envía el string completo a través de UART2
  Serial2.println(mensaje);
}

void getImuInfo(){
  if(bno.getImpact()) //check if an high_g event occured (impact)
  {
    Serial.println("Impact Detected!");
    bno.loadOffsets(100);  //if yes load the calibration values saved in eeprom onto the bno
    while(bno.getHeading()==1);	//discard the first output from the bno because its most likely junk
  }
  IMU = bno.getHeading(); // se actualiza informacion del imu
  //si se registro un impacto en el imu entonces se cargan los valores calibrados en el eeprom para evitar error en el imu
 // Serial.println(IMU);
}

void cero(){
  ceroFake=IMU-calibracionImu;
  if (ceroFake<0){
    ceroFake=360+ceroFake;
  }
  ceroFake = ceroFake/2;
  //Serial.println(ceroFake);
}

void sendToMotorController(int pwm, int orientationError, int movementIndicator, int angleToMove) {
    const byte startMarker = 0xFF;
    const byte endMarker = 0xFE;
    
    // Aseguramos que los valores estén dentro de un rango válido para un byte
    byte pwmByte = constrain(pwm, 0, 255);
    byte orientationErrorByte = constrain(orientationError, 0, 255);
    byte movementIndicatorByte = movementIndicator ? 1 : 0; // Asegurar que solo sea 0 o 1.
    byte angleToMoveByte = constrain(angleToMove, 0, 255); 
    
    // Calculamos el checksum como la suma simple de los datos
    byte checksum = pwmByte + orientationErrorByte + movementIndicatorByte + angleToMoveByte;
    
    // Enviamos los datos
    Serial5.write(startMarker);
    Serial5.write(pwmByte);
    Serial5.write(orientationErrorByte);
    Serial5.write(movementIndicatorByte);
    Serial5.write(angleToMoveByte);
    Serial5.write(checksum);
    Serial5.write(endMarker);
   /* Serial.print("IMU: ");Serial.println(orientationErrorByte);
    Serial.print("Angulo: ");Serial.println(angleToMoveByte);
    Serial.print("pwm: ");Serial.println(pwmByte);*/
}


bool entroPorteria = false;

int ajusteAngulo(int x, int intensidad){
  int anguloModificado = x;
  int dis;
  dis = intensidad -750;
  dis = constrain(dis,300,750);
  if (globalAngle != 400){
    if(x < 180 && x > 10){
      return x+110*dis/900;
    }
    else if(x >= 180 && x < 350){
      return x-90*dis/900;
    }
    else {

      return 0;
    }
  }
  else{
    return 400;
  }
}

int errorPorteriaY(){
  //Serial.print("error y: "); Serial.println(yPorteria-setY);
  return yPorteria - setY;

}
int errorPorteriaX(){
  return xPorteria - setX;
}
int reposicionY(int y){
  if(y > 0 ){
    return 0;
  }
  else{
    return 180;
  }
}


void jugar(){
  //Serial.print("pwm :"); Serial.println(sendPWM);
  int errorY = errorPorteriaY();
  if(errorY < -2){
    sendToMotorController(reposicionPWM(errorY),ceroFake,1,0);
    }
  else if(errorY > 8){
    sendToMotorController(reposicionPWM(errorY),ceroFake,1,90);
  }
  else if(xPorteria > 140){
    sendToMotorController(150,ceroFake,1,135);
  }
  else if(xPorteria < 62){
    sendToMotorController(150,ceroFake,1,45);

  }
  else{
    sendToMotorController(atraparPWM(globalAngle),ceroFake,mover,atraparAngulo(globalAngle)/2);
      //Serial.print("mandado angEsp");
  }
  
}
int reposicionPWM(int error){
  if(error < 0 ){
  error = abs(error);
  error = error*5 +50;
  return constrain(error,60,90);
  }
  else{
  error = abs(error);
    error = error*5 +50;
    return constrain(error,50,130);
  }
}

int atraparPWM(float angulo){
  if(angulo >= 0 && angulo <= 180){
    angulo = angulo*3.1415 / 180;
    angulo = sin(angulo) * pwm;
    return (int) fabs(angulo); 
  }
  else{
    angulo = angulo*3.1415 / 180;
    angulo = sin(angulo) * pwm + 15;
    return (int) fabs(angulo); 
  }
  
}
int atraparAngulo(int angulo){
  if(angulo >= 20 && angulo < 180){
    if(xPorteria  > xMax - 15 ){
      mover = 0;
    }
      else{
        mover = 1;
      }
    return 90;
  }
  else if(angulo >= 180 && angulo < 340){
    if(xPorteria  < xMin + 15){
      mover = 0;
    }
      else{
        mover = 1;
      }
    
    return  270;
  }
  else{
    mover = 0;
    return 0;
  }
}
void setup()
{
  delay(2000);
  uartStart();
  Wire.begin();   //inicia i2C 
  delay(10); //tiempo para que se inicialize i2c
  Wire.setClock(400000); //velocidad el bus i2c, 400000 modo de ultra alta velocidad
  bno.startBNO(200, false);
  pinMode(13, OUTPUT); // led integrado para debugear
  digitalWrite(13, HIGH); 
  inputString.reserve(200); 
  if(Serial3.available() > 0){
    Serial3.clear();
    delay(1);
  }
 /* while(!bno.isCalibrated())	//wait until everything is fully calibrated once....
  {
    bno.serialPrintCalibStat();	//print the current calibration levels via serial
    delay(1000);
  }
  bno.saveOffsets(100);  //....then save the Offsets into the eeprom at the specified address 
*/
} 

int semaforo = 0;
void loop()
{
  
  getImuInfo();
  getUartInfo();

  cero();

  //Serial.println(globalIntensity);
  //Serial.println(traslado());
  //estado = 2; 
  switch (estado){
    case 1: //setMode
      calibracionImu=IMU;
      break;

    case 2: //partido
      jugar();
  
      break;

     case 3:
      Serial.println("calibrarJuanEnLaPista");
      bno.serialPrintCalibStat();
      if(uart2timer > 100){
      llenarDatos();
     uart2timer = 0;
      }
      break;
      case 254:
        estado = 0;
      break;
    default:
     // Serial.println("esperandoAJuan");
     delay(100);
     bno.serialPrintCalibStat();
     if(uart2timer > 100){
     llenarDatos();
     uart2timer = 0;
     }
      break;
  }
  /*if(angEsp == 200 && stop == 0){
    sendToMotors(anguloIR,100,orientacion1,orientacion2, 0);    
  }

  else if(angEsp != 200 && stop == 0 && anguloIR <= 180 && anguloIR >= 0){
    angEsp = sumarAng(angEsp,anguloIR*2);
    sendToMotors(angEsp,100,orientacion1,orientacion2, 0);
    
  }
  else{
    sendToMotors(angEsp,100,orientacion1,orientacion2, 0);
  }*/
      
  
 
 //Serial.println(data5[0] * 2);

}
