chaBotsMX/Robotnik-2024/produccion/portero_0.1/Pcb_IR_Ring_comMejorada_portero/TSSP.cpp

/*************************************************************************/
/*                                                                       */
/*                                                                       */
/****************************CHABOTS ROBOTNIK 2021************************/
/*                                                                       */
/*TSSP V 1.0													         */
/*S.L.P MEXICO                           TIME:14:28:48 PM DATE:06/02/2020*/
/*************************************************************************/

#include "Arduino.h"
#include "TSSP.h"

TSSP::TSSP(){
  for(int i = 0; i<NUM_TSSP; i++)
    pinMode(tssp[i],INPUT);  
}

void TSSP::sensorInfo(){
  const unsigned long startTime_us = micros();
  for(int i=0; i<NUM_TSSP; i++)
    lectura[i]=0;
  do {
    for(int i = 0; i<NUM_TSSP; i++){
      //  Serial.print(digitalRead(tssp[i]));
      //  Serial.print(" ");
      if(!digitalRead(tssp[i])) {
        lectura[i]+=delta;
      }
    }
    //Serial.println();
  } while((micros() - startTime_us) < timeLimit);
}

int TSSP::angleIR(){
  double x1=0;
  double y1=0;
  int counter=0;
  double angle; 
  //Se hace la lectura del arreglo donde estan registradas las lecturas de los TSSPs
  for (int i=0; i<NUM_TSSP;  i++){
    //Si algun tssp marca lectura se hace la suma del vector registrado
    if (lectura[i]>0){
      x1=x1+(lectura[i]*vecx[i]);
      y1=y1+(lectura[i]*vecy[i]);
      counter++;
    }
  }
  counter !=0 ? angle=atan2(x1,y1)/M_PI*180.00 : angle= -1; //Se saca la arcotangente de la suma de los vectores
  angle != -1?  angle = angle+180 : angle = -1;
  return angle;  
}

int TSSP::hipIR(){
  int hip;
  double x1=0;
  double y1=0;
  int counter=0;
  double angle; 
  //Se hace la lectura del arreglo donde estan registradas las lecturas de los TSSPs
  for (int i=0; i<NUM_TSSP;  i++){
  //Si algun tssp marca lectura se hace la suma del vector registrado
    if (lectura[i]>0){
      x1=x1+(lectura[i]*vecx[i]);
      y1=y1+(lectura[i]*vecy[i]);
      
    }
  }
  hip=sqrt(pow(x1,2.0) + pow(y1,2.0));
  return hip;
}

int TSSP::intIR(){
  double intensidad=0;
  int pin;
  for(int i=0; i<NUM_TSSP; i++){
    if(lectura[i]>intensidad){
      intensidad = lectura[i];
      pin = tssp[i];
   }
  }
  intensidad = pulseIn(pin, HIGH, 833);
            //      y = 31241e-0.016x
    
  return intensidad;
}
