chaBotsMX/Robotnik-2024/produccion/portero_0.1/Pcb_IR_Ring_comMejorada_portero/TSSP.h

/*************************************************************************/
/*                                                                       */
/*                                                                       */
/****************************CHABOTS ROBOTNIK 2021************************/
/*                                                                       */
/*TSSP V 1.0    												         */
/*S.L.P MEXICO                           TIME:14:28:48 PM DATE:06/02/2020*/
/*************************************************************************/

#ifndef TSSP_h
#define TSSP_h

#define NUM_TSSP 16

class TSSP{
public:
    TSSP();
    void sensorInfo();
    int angleIR();
    int hipIR();
    int intIR();
private:
    long timeLimit=877;
    int count=0;
    unsigned long time_ms = 0;
    int lectura[NUM_TSSP];
    int tssp[NUM_TSSP]={12,13,14,15,18,19,2,3,4,5,6,7,8,9,10,11};
    double vecx[NUM_TSSP]={0.0,0.3826834323650898,0.7071067811865475,0.9238795325112867,1.0,0.9238795325112867,0.7071067811865476,0.3826834323650899,-0.0,-0.3826834323650898,-0.7071067811865475,-0.9238795325112867,-1.0,-0.9238795325112867,-0.7071067811865476,-0.3826834323650899};
    double vecy[NUM_TSSP]={1.0,0.9238795325112867,0.7071067811865476,0.38268343236508984,6.123233995736766e-17,-0.3826834323650897,-0.7071067811865475,-0.9238795325112867,-1.0,-0.9238795325112867,-0.7071067811865476,-0.38268343236508984,-6.123233995736766e-17,0.3826834323650897,0.7071067811865475,0.9238795325112867};
    float delta=3.0;
    double sum_x;
    double sum_y;
};

#endif
