chaBotsMX/Robotnik-2024/(commit log)

2023-10-02 tssp que si sirve
2023-10-03 libreria rasp uart
2023-10-06 uart rasp
2024-01-13 pines actualizados, sensor funcional.
2024-01-23 M5Stack Prueba de botones
2024-01-26 M5 Botones uart
2024-02-24 cambios a la trayectoria de la pelota, funcionamiento del anillo
2024-03-11 cambios a la comunicacion de las placas para enviar mas bytes, añadiendo checksum y prevencion de erroees, tambien reconeccion, aun falta probarse en robot
2024-03-18 trabajo realizado el sabado 16 de marzo, camara funcionando, teensy recibe coordenadaas, ARREGLAS SENSOR DE LINEA
    [Main_Pcb_comMejorada.ino, Pcb_Motores_comMejorada.ino, camara.py, m5prueba1_copy_20240121173754.ino]
2024-03-19 pruyebas pid y correcion funcion traslado, arreglas sensor de linea
    [Main_Pcb_comMejorada.ino, Pcb_Motores_comMejorada.ino]
2024-03-21 cambiar teensy
2024-03-22 pcb principal funcionando, todo funcionando, falta arreglas la camara
    [Main_Pcb_comMejorada.ino, Pcb_IR_Ring_comMejorada.ino]
2024-03-23 camara arreglada, velocidad proporcional
    [Main_Pcb.ino, Main_Pcb_comMejorada.ino, Pcb_IR_Ring_comMejorada.ino, Pcb_Motores.ino, Pcb_Motores_comMejorada.ino, TSSP.cpp, TSSP.h, camara.py]
2024-03-25 angulo de la porteria
2024-03-26 Pruebas comunicacion wireless esp32 si funciona xd
2024-04-03 calibrar sensor de linea
